bikerglen/poe-vfd-clock/boards/v1/control-board-page-1.png

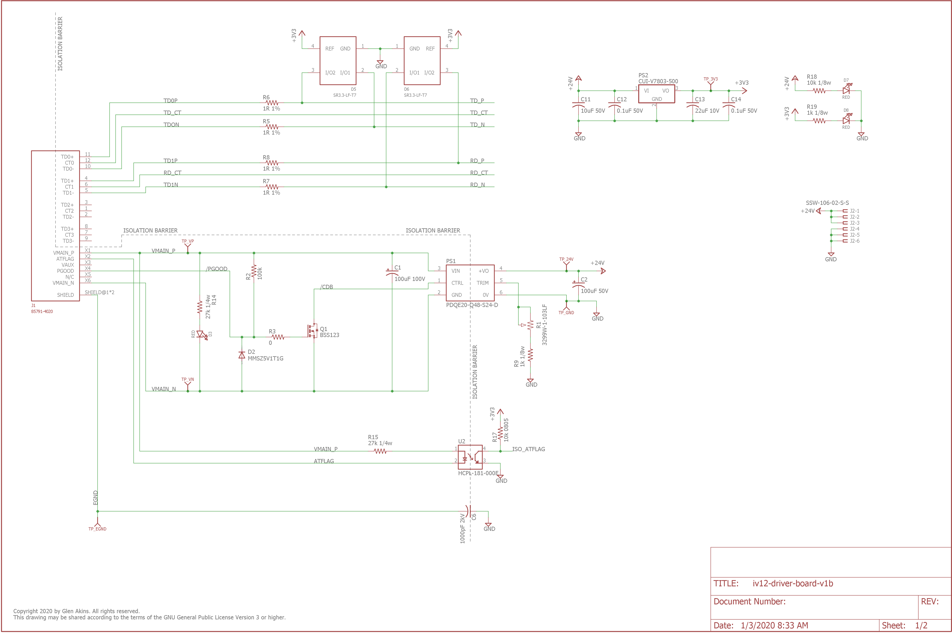
boards/v1/control-board-page-1.png
