bikerglen/poe-vfd-clock/boards/v1/control-board-page-2.png

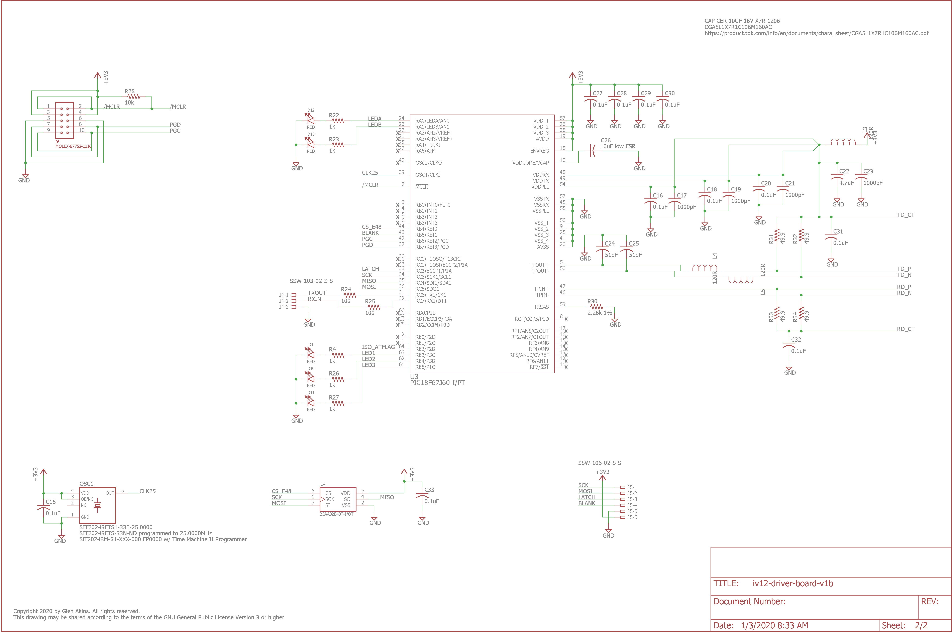
boards/v1/control-board-page-2.png
