bikerglen/poe-vfd-clock/boards/v1/tube-board-page-1.png

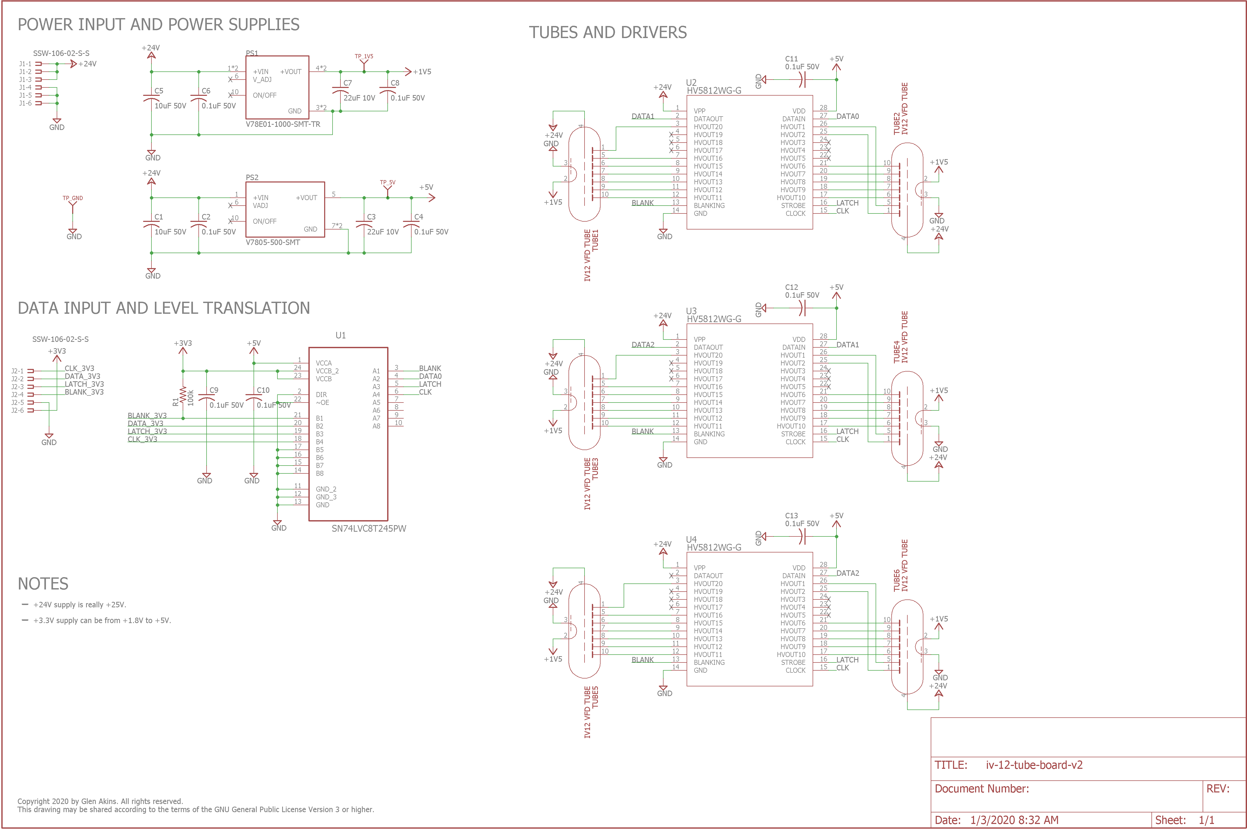
boards/v1/tube-board-page-1.png
