bikerglen/poe-vfd-clock/boards/v1/iv-12-project-bom.xlsx

Qty | Parts | Description | Size | Mfr | Mfr Part # | Dist | Dist Part 3 | Notes
2 | C1, C5 | CAP CER 10uF 50V 10% X7R SMD 1210 | 1210 | Kemet | C1210C106K5RACTU | Digi-Key | 399-11629-1-ND
4 | C2, C4, C6, C8 | CAP CER 0.1UF 50V X7R 1206 | 1206 | Kemet | C1206C104K5RAC7025 | Digi-Key | 399-7356-1-ND
2 | C3, C7 | CAP CER 22uF 10V 10% X7R SMD 1206 | 1206 | Kemet | C1206C226K8RAC7800 | Digi-Key | 399-11947-1-ND
5 | C9, C10, C11, C12, C13 | CAP CER 0.1u 50V 10% X7R SMD 0805 | 0805 | Kemet | C0805C104K5RACTU | Digi-Key | 399-1170-1-ND
2 | J1,J2 | CONN RCPT 6POS 0.1 GOLD PCB | --- | Samtec | ‎SSW-106-01-G-S‎ | Digi-Key | SAM1209-06-ND
1 | PS1 | DC-DC NON-ISOLATED, 1 A, 4.75 32 | --- | Cui | V78E01-1000-SMT-TR | Digi-Key | 102-5030-1-ND
1 | PS2 | DC DC CONVERTER 5V 2.5W | --- | Cui | V7805-500-SMT-TR | Digi-Key | 102-1958-1-ND
1 | R1 | RES SMD 100K OHM 5% 1/8W 0805 | 0805 | Panasonic | ERJ-6GEYJ104V | Digi-Key | P100KACT-ND
3 | TP1, TP2, TP3 | PC TEST POINT MINIATURE | --- | Keystone | 5000 | Digi-Key | 36-5000-ND
6 | TUBE1 - TUBE6 | IN12 VFD TUBE | --- | --- | --- | --- | ---
1 | U1 | IC TRNSLTR BIDIRECTIONAL 24TSSOP | --- | Texas Instruments | ‎SN74LVC8T245PWR‎ | Digi-Key | 296-18593-1-ND‎
3 | U2,U3,U4 | IC DISPLAY DVR 20CH 80V 28SOIC | --- | Microchip | ‎HV5812WG-G‎ | Digi-Key | HV5812WG-GCT-ND‎
60 | --- | CONN PIN RCPT .035-.041 KNURL | --- | Harwin | H3161-01 | Digi-Key | 952-1467-ND
4 | --- | M3 x 0.5 x 11MM F-F THREADED STANDOFF | --- | Würth Elektronik | ‎970110324‎ | Digi-Key | 732-12849-ND‎
8 | --- | M3 x 0.5 x 6MM PAN HEAD HEX SCREW | --- | McMaster Carr | 92095A179 | McMaster Carr | 92095A179
1 | C1 | CAP ALUM 100UF 20% 100V RADIAL | 12.5x5x14 | Nichicon | URY2A101MHD1TO | Digi-Key | 493-12135-1-ND
1 | C2 | CAP ALUM 100UF 20% 50V RADIAL | 10x5x10.5 | Nichicon | URZ1H101MPD1TD | Digi-Key | 493-11877-1-ND
1 | C6 | CAP CER 1000pF 2KV 10% X7R SMD 1206 | 1206 | Johanson Dielectrics | 202R18W102KV4E | Digi-Key | 709-1036-1-ND
1 | C11 | CAP CER 10uF 50V 10% X7R SMD 1210 | 1210 | Kemet | C1210C106K5RACTU | Digi-Key | 399-11629-1-ND
2 | C12, C14 | CAP CER 0.1u 50V 10% X7R SMD 0805 | 0805 | Kemet | C0805C104K5RACTU | Digi-Key | 399-1170-1-ND
1 | C13 | CAP CER 22uF 10V 10% X7R SMD 1206 | 1206 | Kemet | C1206C226K8RAC7800 | Digi-Key | 399-11947-1-ND
6 | C15, C27, C28, C29, C30, C33 | CAP CER 0.1uF 50V 20% X7R SMD 0603 | 0603 | TDK | C1608X7R1H104M | Digi-Key | 445-5098-1-ND
5 | C16, C18, C20, C31, C32 | CAP CER 0.1u 50V 10% X7R SMD 0805 | 0805 | Kemet | C0805C104K5RACTU | Digi-Key | 399-1170-1-ND
4 | C17, C19, C21, C23 | CAP CER 1000pF 50V 20% X7R SMD 0805 | 0805 | Kemet | C0805C102M5RACTU | Digi-Key | 399-1146-1-ND
1 | C22 | CAP CER 4.7uF 10V 10% X5R SMD 0805 | 0805 | Kemet | C0805C475K8PACTU | Digi-Key | 399-3133-1-ND
2 | C24, C25 | CAP CER 51pF 50V 5% NP0 SMD 0805 | 0805 | Yageo | CC0805JRNPO9BN510 | Digi-Key | 311-4239-1-ND
1 | C26 | CAP CER 10uF 16V 20% X7R SMD 1206 | 1206 | TDK | CGA5L1X7R1C106M160AC | Digi-Key | 445-12903-1-ND
8 | D1, D3, D7, D8, D10, D11, D12, D13 | LED RED CLEAR CHIP SMD 0805 | 0805 | Kingbright | APHCM2012SURCK-F01 | Digi-Key | 754-1097-1-ND
1 | D2 | Zener Diodes ZNR SOD123 500MW | SOD123 | On Semi | SZMMSZ5V1T1G | Mouser | 863-SZMMSZ5V1T1G
2 | D5, D6 | TVS DIODE 3.3V 7V SOT143 | --- | Bourns | CD143A-SR3.3 | Digi-Key | CD143A-SR3.3CT-ND
1 | J1 | MAGJACK GIG PDJACK 1X1 CLASS 4 | --- | Molex | 0857914020 | Digi-Key | WM9656-ND
2 | J2, J5 | CONN HEADER VERT 6POS 2.54MM | --- | Samtec | TSW-106-07-G-S | Digi-Key | SAM1029-06-ND
1 | J4 | CONN HEADER VERT 3POS 2.54MM | --- | Samtec | TSW-103-07-G-S | Digi-Key | SAM1029-03-ND
1 | J6 | CONN HEADER VERT 10POS 2MM | --- | Molex | 0877581016 | Digi-Key | WM18836-ND
3 | L3, L4, L5 | FERRITE BEAD 120 OHM 0603 1LN | M1608 | TDK | MMZ1608B121CTAH0 | Digi-Key | 445-2164-1-ND
1 | OSC1 | MEMS OSC PROG XO LVCMOS 3.3V | --- | Si Time | SIT2024BETS-33N | Digi-Key | SIT2024BETS-33N-ND | 25.0000 MHz
1 | PS1 | DC-DC ISOLATED, 20 W, 18-75 VDC | --- | Cui | PDQE20-Q48-S24-D | Digi-Key | 102-6275-ND
1 | PS2 | DC DC CONVERTER 3.3V 1.65W | --- | Cui | V7803-500 | Digi-Key | 102-1708-ND
1 | Q1 | MOSFET MOSFET SOT-23 N-CH | SOT23 | On Semi | BSS123 | Mouser | 512-BSS123
1 | R1 | RES SMD 51K OHM 5% 1/8W 0805 | 0805 | Panasonic | ERJ-6GEYJ513V | Digi-Key | P51KACT-ND
1 | R9 | TRIMMER 10K OHM 0.5W PC PIN TOP | --- | Bourns | 3299W-1-103LF | Digi-Key | 3299W-103LF-ND
2 | R14, R15 | RES SMD 27K OHM 5% 1/4W 1206 | 1206 | Panasonic | ERJ-8GEYJ273V | Digi-Key | P27KECT-ND
1 | R30 | RES SMD 2.26K OHM 1% 1/8W 0805 | 0805 | Panasonic | ERJ-6ENF2261V | Digi-Key | P2.26KCCT-ND
4 | R31, R32, R33, R34 | RES SMD 49.9 OHM 1% 1/8W 0805 | 0805 | Panasonic | ERJ-6ENF49R9V | Digi-Key | P49.9CCT-ND
1 | R2 | RES SMD 100K OHM 5% 1/8W 0805 | 0805 | Panasonic | ERJ-6GEYJ104V | Digi-Key | P100KACT-ND
1 | R3 | Thick Film Resistors - SMD 0805 Zero ohm Jumper AEC-Q200 | 0805 | Panasonic | ERJ-S060R00V | Mouser | 667-ERJ-S060R00V
6 | R4, R19, R22, R23, R26, R27 | RES SMD 1K OHM 5% 1/8W 0805 | 0805 | Panasonic | ERJ-6GEYJ102V | Digi-Key | P1.0KACT-ND
4 | R5, R6, R7, R8 | RES SMD 1 OHM 1% 1/8W 0805 | 0805 | Panasonic | ERJ-6RQF1R0V | Digi-Key | P1.0DCT-ND
3 | R17, R18, R28 | RES SMD 10K OHM 5% 1/8W 0805 | 0805 | Panasonic | ERJ-6GEYJ103V | Digi-Key | P10KACT-ND
2 | R24, R25 | RES SMD 100 OHM 5% 1/8W 0805 | 0805 | Panasonic | ERJ-6GEYJ101V | Digi-Key | P100ACT-ND
6 | TP1, TP2, TP3, TP4, TP5, TP6 | PC TEST POINT MINIATURE | --- | Keystone | 5000 | Digi-Key | 36-5000-ND
1 | U2 | OPTOISO 3.75KV TRANSISTOR 4SOIC | --- | Broadcom | HCPL-181-000E | Digi-Key | 516-1646-1-ND
1 | U3 | IC MCU 8BIT 128KB FLASH 64TQFP | --- | Microchip | PIC18F67J60-I/PT | Digi-Key | PIC18F67J60-I/PT-ND
1 | U4 | IC EEPROM 2K SPI 10MHZ SOT23-6 | --- | Microchip | 25AA02E48T-I/OT | Digi-Key | 25AA02E48T-I/OTCT-ND
 | ORDERED
 | ON-HAND
 | ORDER
