bikerglen/poe-vfd-clock/boards/v1/iv12-driver-board-v1b.brd

## EAGLE design boards/v1/iv12-driver-board-v1b.brd (2020-01-13)

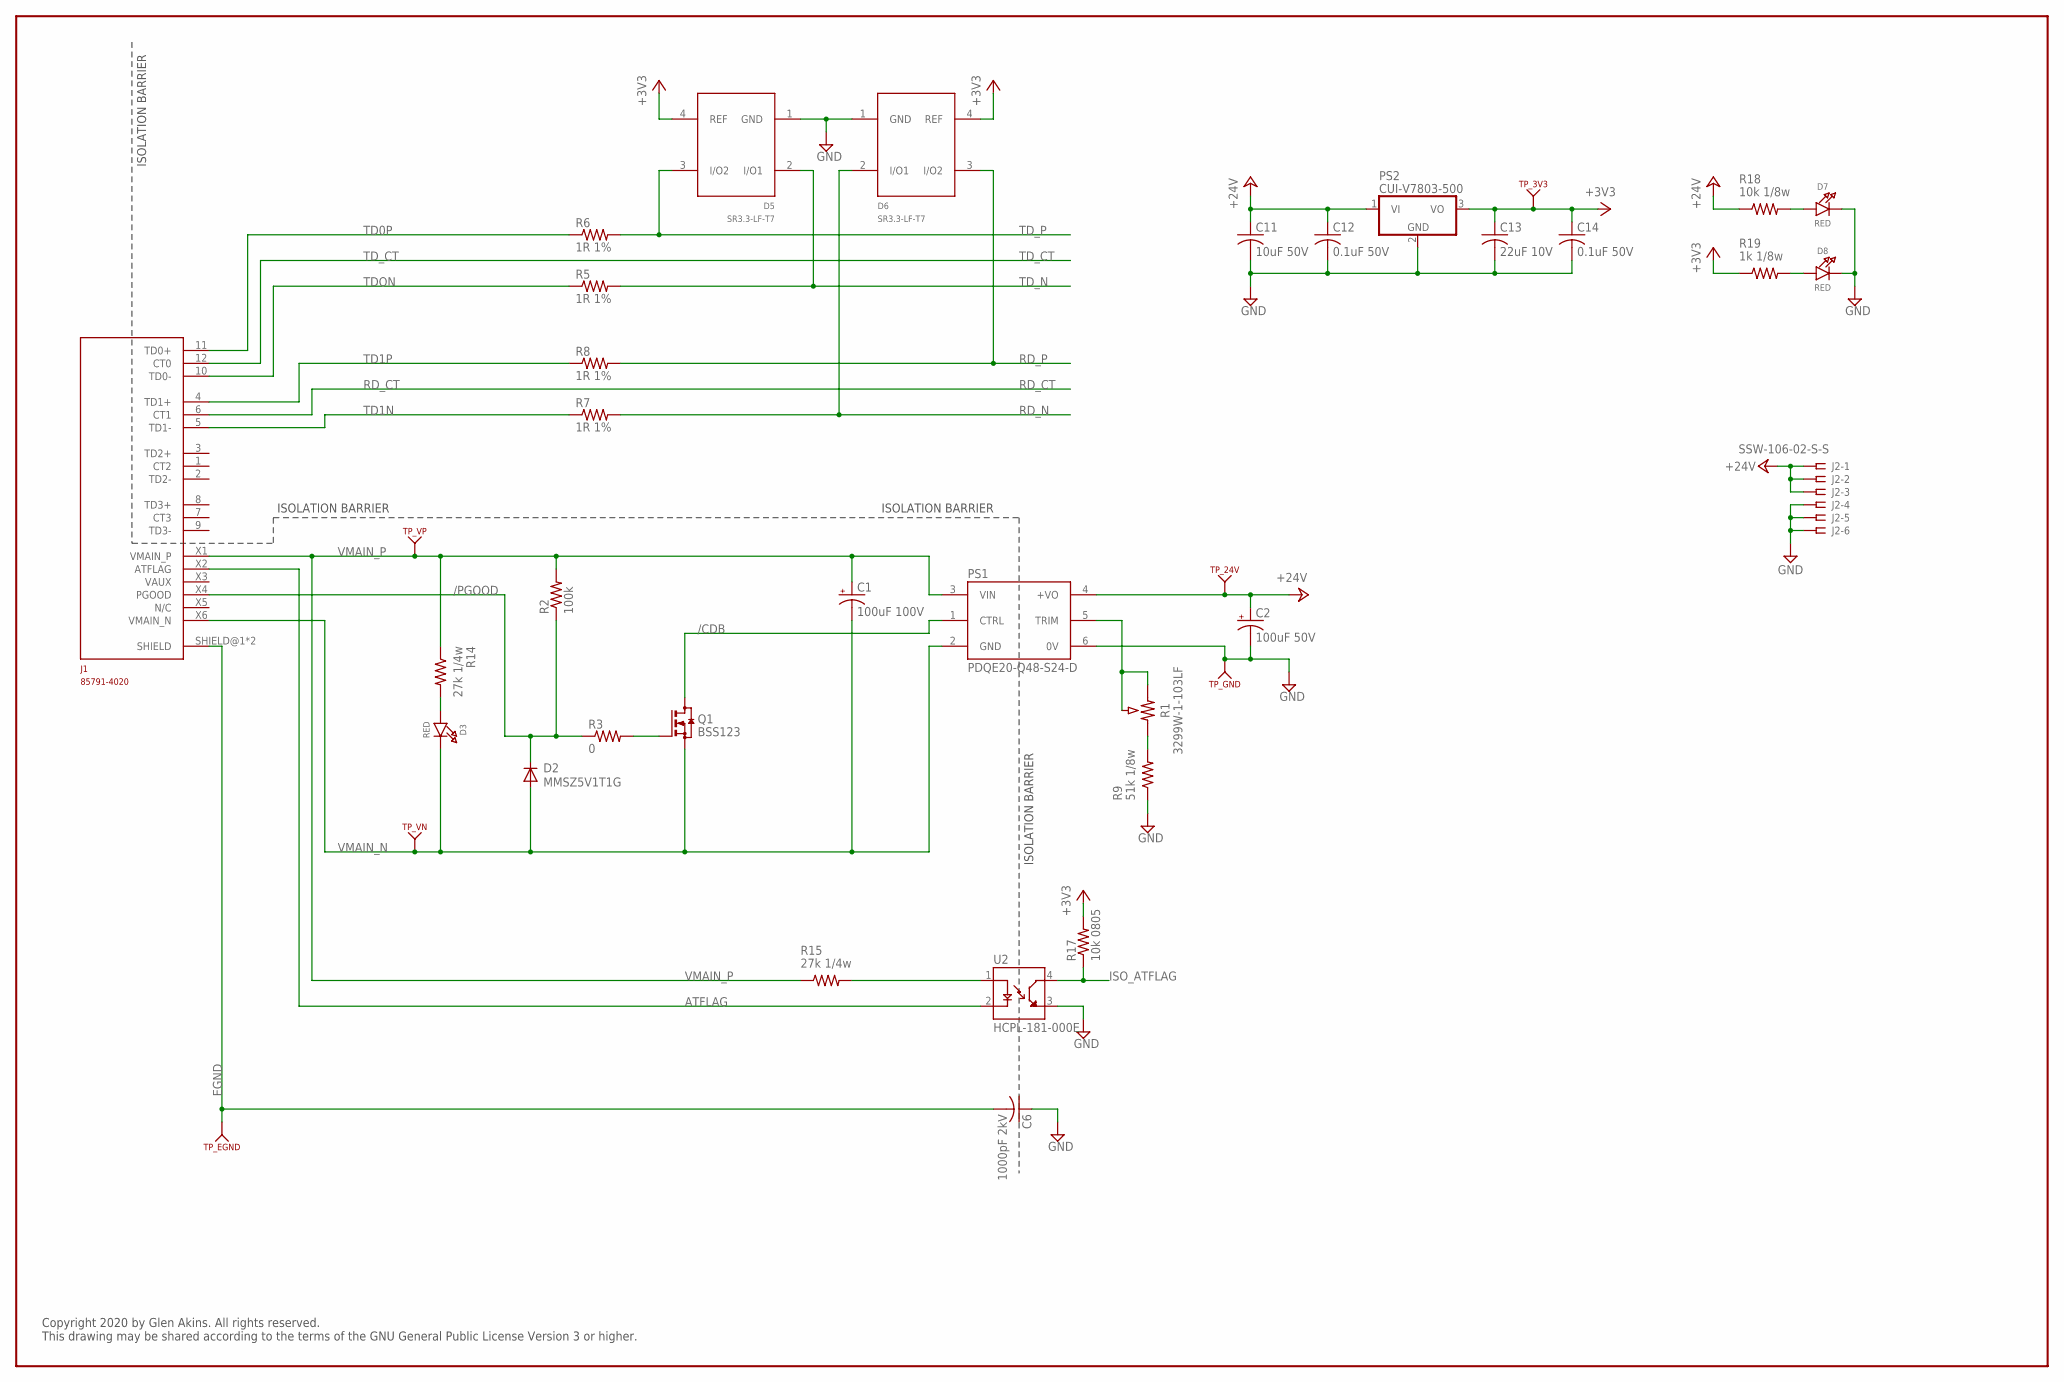
[picture p4: schematic iv12-driver-board-v1b.sch, sheet 1]

Parts:
C1: 100uF 100V; E5-13
C2: 100uF 50V; E5-10,5
C6: 1000pF 2kV; C1206K
C11: 10uF 50V; C1210K; MFR_PART_NO C1210C106K5RACTU
C12, C14: 0.1uF 50V; C0805; MFR_PART_NO C1206S104M5RACTU
C13: 22uF 10V; C1206K; MFR_PART_NO C1206C226K8RAC7800
D2: MMSZ5V1T1G; SOD123
D3, D7, D8: RED; CHIPLED_0805_NOOUTLINE
D5, D6: SR3.3-LF-T7; SOT143B
J1: 85791-4020; 85791-X020
J2: SSW-106-02-S-S
PS1: PDQE20-Q48-S24-D; CONV_PDQE20-Q48-S5-D
PS2: CUI-V7803-500; CUI-78XX-500
Q1: BSS123; SOT23
R1: 3299W-1-103LF; POT_3299W
R2: 100k; R0805
R3: 0; R0805
R5, R6, R7, R8: 1R 1%; R0805
R9: 51k 1/8w; R0805
R14, R15: 27k 1/4w; R1206
R17: 10k 0805; R0805
R18: 10k 1/8w; R0805
R19: 1k 1/8w; R0805
TP_3V3, TP_24V: KEYSTONE_500X; KEYSTONE_TP500X
TP_EGND: KEYSTONE_500X; KEYSTONE_TP500X
TP_GND: KEYSTONE_500X; KEYSTONE_TP500X
TP_VN: KEYSTONE_500X; KEYSTONE_TP500X
TP_VP: KEYSTONE_500X; KEYSTONE_TP500X
U2: HCPL-181-000E; SOIC254P675X240-4N

Connections:
+3V3: C13.1, C14.1, D5.4 (REF), D6.4 (REF), PS2.3 (VO), R17.2, R19.1, TP_3V3.1; also elsewhere on the board
+24V: C2.+, C11.1, C12.1, J2.1, J2.2, J2.3, PS1.4 (+VO), PS2.1 (VI), R18.1, TP_24V.1
/CDB: PS1.1 (CTRL), Q1.3 (D)
/PGOOD: D2.C, J1.X4 (PGOOD), R2.1, R3.1
ATFLAG: J1.X2 (ATFLAG), U2.2 (CATHODE)
EGND: C6.2, J1.SHIELD@1 (SHIELD), J1.SHIELD@2 (SHIELD), TP_EGND.1
GND: C2.-, C6.1, C11.2, C12.2, C13.2, C14.2, D5.1 (GND), D6.1 (GND), D7.C, D8.C, J2.4, J2.5, J2.6, PS1.6 (0V), PS2.2 (GND), R9.1, TP_GND.1, U2.3 (EMITTER); also elsewhere on the board
ISO_ATFLAG: R17.1, U2.4 (COLLECTOR); also elsewhere on the board
unnamed: R1.1, R9.2
unnamed: R15.2, U2.1 (ANODE)
unnamed: Q1.1 (G), R3.2
unnamed: D3.A, R14.2
unnamed: D7.A, R18.2
unnamed: D8.A, R19.2
RD_CT: J1.6 (CT1); also elsewhere on the board
RD_N: D6.2 (I/O1), R7.2; also elsewhere on the board
RD_P: D6.3 (I/O2), R8.2; also elsewhere on the board
TD0P: J1.11 (TD0+), R6.1
TD1N: J1.5 (TD1-), R7.1
TD1P: J1.4 (TD1+), R8.1
TDON: J1.10 (TD0-), R5.1
TD_CT: J1.12 (CT0); also elsewhere on the board
TD_N: D5.2 (I/O1), R5.2; also elsewhere on the board
TD_P: D5.3 (I/O2), R6.2; also elsewhere on the board
V24ADJ: PS1.5 (TRIM), R1.2, R1.3
VMAIN_N: C1.-, D2.A, D3.C, J1.X6 (VMAIN_N), PS1.2 (GND), Q1.2 (S), TP_VN.1
VMAIN_P: C1.+, J1.X1 (VMAIN_P), PS1.3 (VIN), R2.2, R14.1, R15.1, TP_VP.1

Notes on the sheet:
ISOLATION BARRIER
Copyright 2020 by Glen Akins. All rights reserved. This drawing may be shared according to the terms of the GNU General Public License Version 3 or higher.

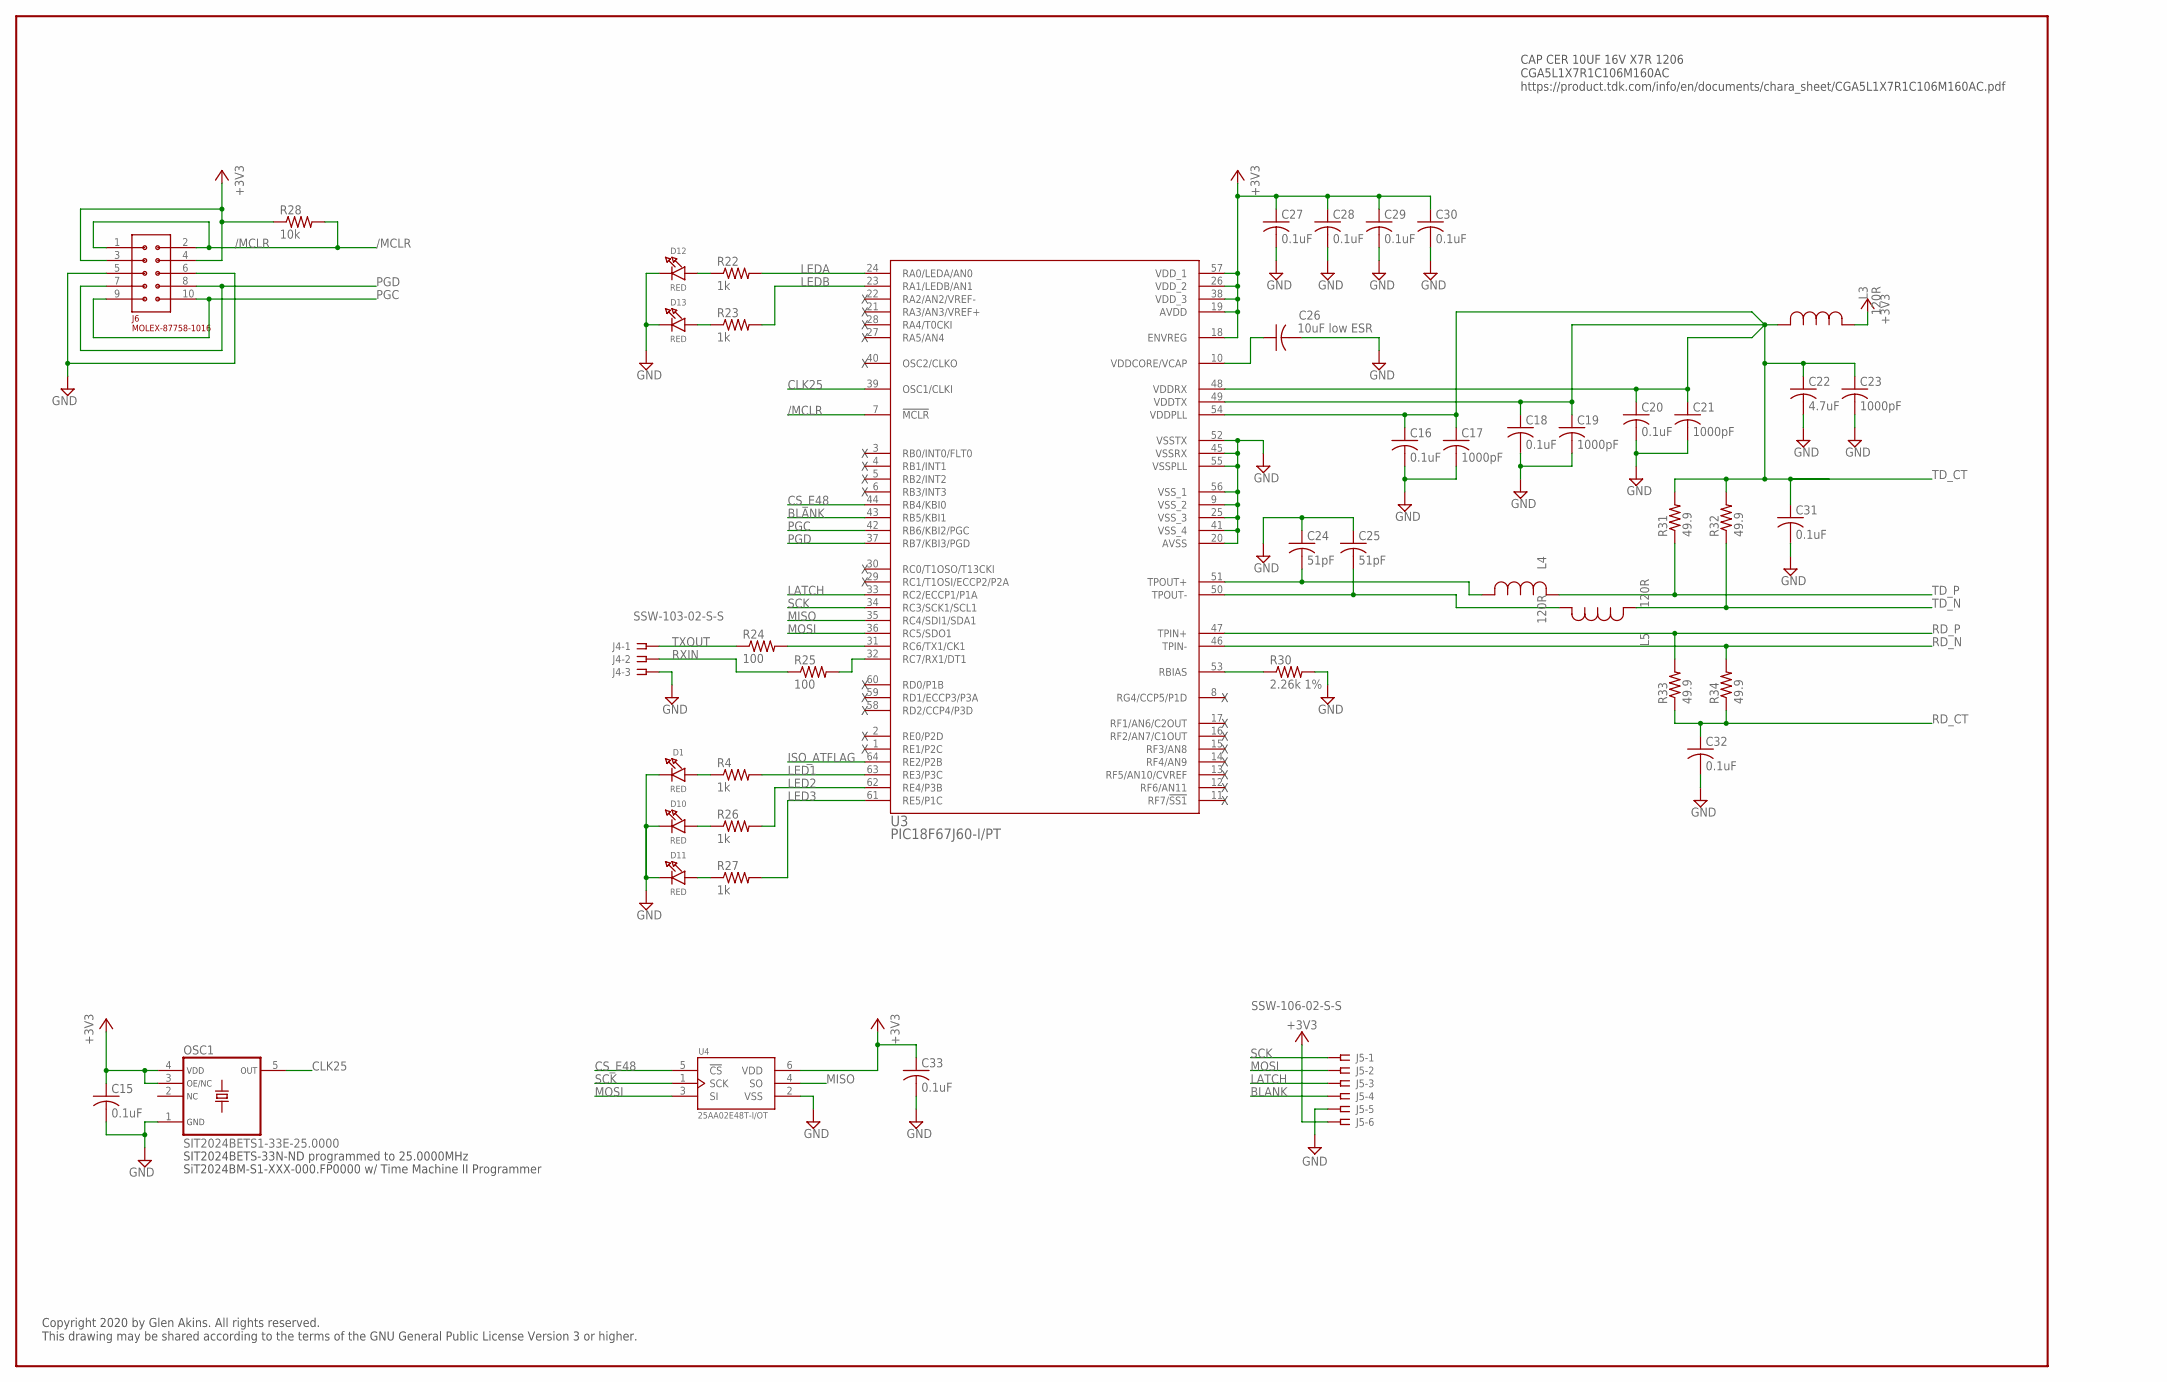
[picture p5: schematic iv12-driver-board-v1b.sch, sheet 2]

Parts:
C15, C27, C28, C29, C30, C33: 0.1uF; C0603
C16, C18, C20, C31, C32: 0.1uF; C0805
C17, C19, C21, C23: 1000pF; C0805
C22: 4.7uF; C0805
C24, C25: 51pF; C0805
C26: 10uF low ESR; C1206
D1, D10, D11, D12, D13: RED; CHIPLED_0805_NOOUTLINE
J4: SSW-103-02-S-S
J5: SSW-106-02-S-S
J6: MOLEX-87758-1016; CON-2MM-2X5; MFR_PART_NO 87758-1016
L3, L4, L5: 120R; IND_1608-M
OSC1: SIT2024BETS1-33E-25.0000; SOT23-5
R4, R22, R23, R26, R27: 1k; R0805
R24, R25: 100; R0805
R28: 10k; R0805
R30: 2.26k 1%; R0805
R31, R32, R33, R34: 49.9; R0805
U3: PIC18F67J60-I/PT; TQFP64_10X10MC
U4: 25AA02E48T-I/OT; SOT95P270X145-6N

Connections:
+3V3: C15.1, C27.1, C28.1, C29.1, C30.1, C33.1, J5.6, J6.3, J6.4, L3.2, OSC1.3 (OE/NC), OSC1.4 (VDD), R28.1, U3.18 (ENVREG), U3.19 (AVDD), U3.26 (VDD_2), U3.38 (VDD_3), U3.57 (VDD_1), U4.6 (VDD); also elsewhere on the board
/MCLR: J6.1, J6.2, R28.2, U3.7 (!MCLR)
BLANK: J5.4, U3.43 (RB5/KBI1)
CLK25: OSC1.5 (OUT), U3.39 (OSC1/CLKI)
CS_E48: U3.44 (RB4/KBI0), U4.5 (!CS)
GND: C15.2, C16.2, C17.2, C18.2, C19.2, C20.2, C21.2, C22.2, C23.2, C24.1, C25.1, C26.2, C27.2, C28.2, C29.2, C30.2, C31.2, C32.2, C33.2, D1.C, D10.C, D11.C, D12.C, D13.C, J4.3, J5.5, J6.5, J6.6, OSC1.1 (GND), R30.2, U3.9 (VSS_2), U3.20 (AVSS), U3.25 (VSS_3), U3.41 (VSS_4), U3.45 (VSSRX), U3.52 (VSSTX), U3.55 (VSSPLL), U3.56 (VSS_1), U4.2 (VSS); also elsewhere on the board
ISO_ATFLAG: U3.64 (RE2/P2B); also elsewhere on the board
LATCH: J5.3, U3.33 (RC2/ECCP1/P1A)
LED1: R4.2, U3.63 (RE3/P3C)
LED2: R26.2, U3.62 (RE4/P3B)
LED3: R27.2, U3.61 (RE5/P1C)
LEDA: R22.2, U3.24 (RA0/LEDA/AN0)
LEDB: R23.2, U3.23 (RA1/LEDB/AN1)
MISO: U3.35 (RC4/SDI1/SDA1), U4.4 (SO)
MOSI: J5.2, U3.36 (RC5/SDO1), U4.3 (SI)
unnamed: D1.A, R4.1
unnamed: R30.1, U3.53 (RBIAS)
unnamed: D13.A, R23.1
unnamed: D10.A, R26.1
unnamed: D11.A, R27.1
unnamed: D12.A, R22.1
PGC: J6.9, J6.10, U3.42 (RB6/KBI2/PGC)
PGD: J6.7, J6.8, U3.37 (RB7/KBI3/PGD)
RD_CT: C32.1, R33.1, R34.1; also elsewhere on the board
RD_N: R34.2, U3.46 (TPIN-); also elsewhere on the board
RD_P: R33.2, U3.47 (TPIN+); also elsewhere on the board
RXD: R25.2, U3.32 (RC7/RX1/DT1)
RXIN: J4.2, R25.1
SCK: J5.1, U3.34 (RC3/SCK1/SCL1), U4.1 (SCK)
TDF_N: C25.2, L5.1, U3.50 (TPOUT-)
TDF_P: C24.2, L4.1, U3.51 (TPOUT+)
TD_CT: C16.1, C17.1, C18.1, C19.1, C20.1, C21.1, C22.1, C23.1, C31.1, L3.1, R31.2, R32.2, U3.48 (VDDRX), U3.49 (VDDTX), U3.54 (VDDPLL); also elsewhere on the board
TD_N: L5.2, R32.1; also elsewhere on the board
TD_P: L4.2, R31.1; also elsewhere on the board
TXD: R24.2, U3.31 (RC6/TX1/CK1)
TXOUT: J4.1, R24.1
VCAP: C26.1, U3.10 (VDDCORE/VCAP)

Notes on the sheet:
SIT2024BETS-33N-ND programmed to 25.0000MHz
SiT2024BM-S1-XXX-000.FP0000 w/ Time Machine II Programmer
CAP CER 10UF 16V X7R 1206 CGA5L1X7R1C106M160AC https://product.tdk.com/info/en/documents/chara_sheet/CGA5L1X7R1C106M160AC.pdf
Copyright 2020 by Glen Akins. All rights reserved. This drawing may be shared according to the terms of the GNU General Public License Version 3 or higher.

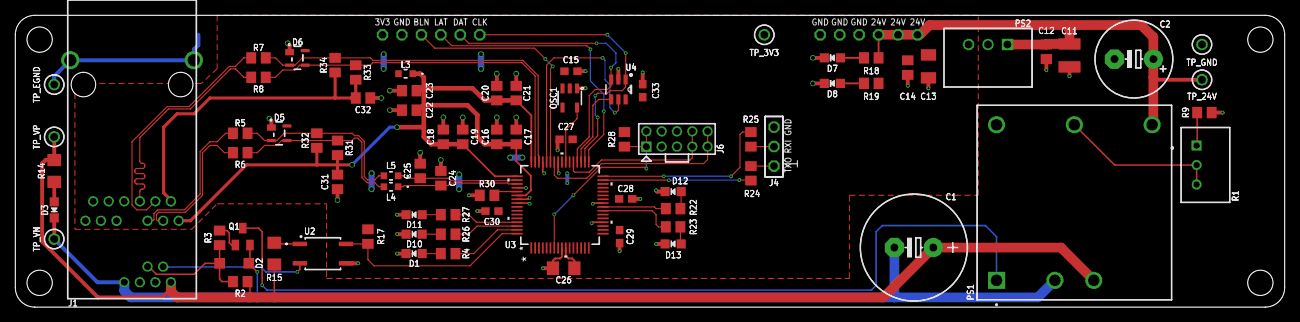
[picture p6: board iv12-driver-board-v1b.brd from above]

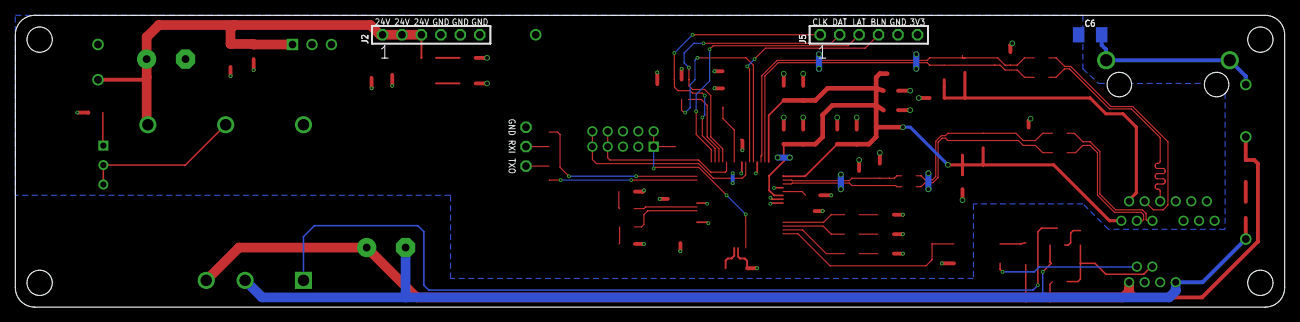
[picture p7: board iv12-driver-board-v1b.brd from below]

Board: 2 copper layers, 165.7 x 38.1 mm, 84 parts (3 on the bottom side), 55 nets.
