bikerglen/poe-vfd-clock/boards/v1/iv-12-tube-board-v2.brd

## EAGLE design boards/v1/iv-12-tube-board-v2.brd (2020-01-12)

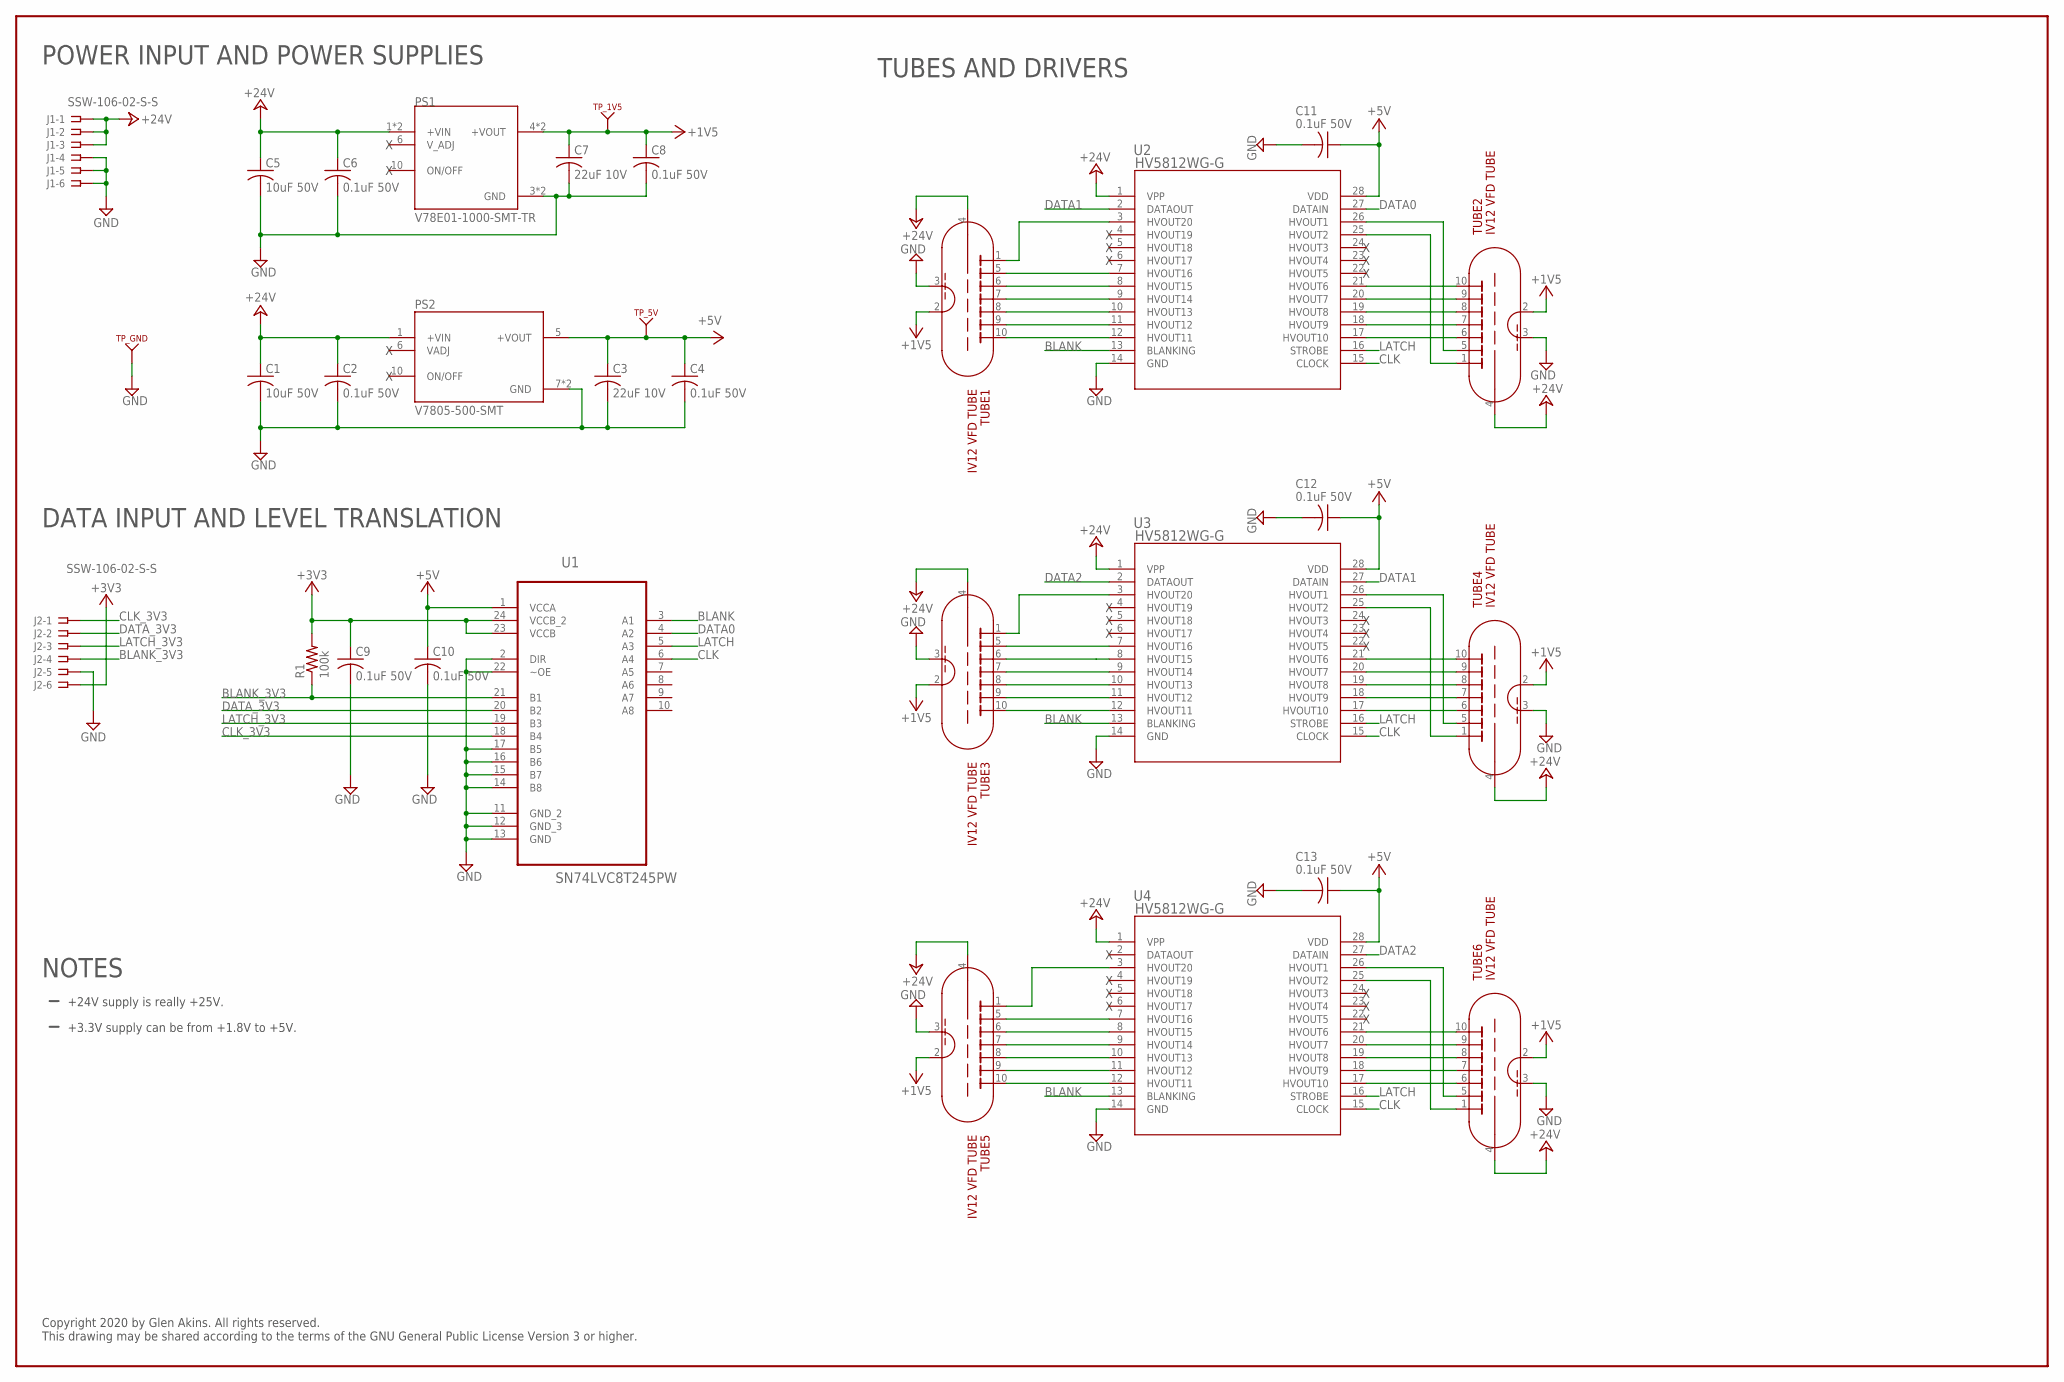
[picture p8: schematic iv-12-tube-board-v2.sch, sheet 1]

Parts:
C1, C5: 10uF 50V; C1210K; MFR_PART_NO C1210C106K5RACTU
C2, C4, C6, C8: 0.1uF 50V; C1206K; MFR_PART_NO C1206S104M5RACTU
C3, C7: 22uF 10V; C1206K; MFR_PART_NO C1206C226K8RAC7800
C9, C10: 0.1uF 50V; C0805K
C11, C12, C13: 0.1uF 50V; C0805
J1, J2: SSW-106-02-S-S
PS1: V78E01-1000-SMT-TR; CONV_V78E01-1000-SMT-TR
PS2: V7805-500-SMT; CONV_V7805-500-SMT
R1: 100k; R0805
TP_1V5, TP_5V: KEYSTONE_500X; KEYSTONE_TP500X
TP_GND: KEYSTONE_500X; KEYSTONE_TP500X
TUBE1, TUBE2, TUBE3, TUBE4, TUBE5, TUBE6: IV12 VFD TUBE; IV-12-VFD-TUBE-11.9MM-10PIN-34DEG
U1: SN74LVC8T245PW; SOP65P640X120-24N
U2, U3, U4: HV5812WG-G; SOW28_17P90X7P50

Connections:
+1V5: C7.1, C8.1, PS1.4 (+VOUT), PS1.5 (+VOUT), TP_1V5.1, TUBE1.2, TUBE2.2, TUBE3.2, TUBE4.2, TUBE5.2, TUBE6.2
+3V3: C9.1, J2.6, R1.2, U1.23 (VCCB), U1.24 (VCCB_2)
+5V: C3.1, C4.1, C10.1, C11.1, C12.1, C13.1, PS2.5 (+VOUT), TP_5V.1, U1.1 (VCCA), U2.28 (VDD), U3.28 (VDD), U4.28 (VDD)
+24V: C1.1, C2.1, C5.1, C6.1, J1.1, J1.2, J1.3, PS1.1 (+VIN), PS1.2 (+VIN), PS2.1 (+VIN), TUBE1.4, TUBE2.4, TUBE3.4, TUBE4.4, TUBE5.4, TUBE6.4, U2.1 (VPP), U3.1 (VPP), U4.1 (VPP)
BLANK: U1.3 (A1), U2.13 (BLANKING), U3.13 (BLANKING), U4.13 (BLANKING)
BLANK_3V3: J2.4, R1.1, U1.21 (B1)
CLK: U1.6 (A4), U2.15 (CLOCK), U3.15 (CLOCK), U4.15 (CLOCK)
CLK_3V3: J2.1, U1.18 (B4)
DATA0: U1.4 (A2), U2.27 (DATAIN)
DATA1: U2.2 (DATAOUT), U3.27 (DATAIN)
DATA2: U3.2 (DATAOUT), U4.27 (DATAIN)
DATA_3V3: J2.2, U1.20 (B2)
GND: C1.2, C2.2, C3.2, C4.2, C5.2, C6.2, C7.2, C8.2, C9.2, C10.2, C11.2, C12.2, C13.2, J1.4, J1.5, J1.6, J2.5, PS1.3 (GND), PS1.7 (GND), PS2.7 (GND), PS2.9 (GND), TP_GND.1, TUBE1.3, TUBE2.3, TUBE3.3, TUBE4.3, TUBE5.3, TUBE6.3, U1.2 (DIR), U1.11 (GND_2), U1.12 (GND_3), U1.13 (GND), U1.14 (B8), U1.15 (B7), U1.16 (B6), U1.17 (B5), U1.22 (~OE), U2.14 (GND), U3.14 (GND), U4.14 (GND)
LATCH: U1.5 (A3), U2.16 (STROBE), U3.16 (STROBE), U4.16 (STROBE)
LATCH_3V3: J2.3, U1.19 (B3)
unnamed: TUBE1.1, U2.3 (HVOUT20)
unnamed: TUBE1.10, U2.12 (HVOUT11)
unnamed: TUBE1.9, U2.11 (HVOUT12)
unnamed: TUBE1.8, U2.10 (HVOUT13)
unnamed: TUBE1.7, U2.9 (HVOUT14)
unnamed: TUBE1.6, U2.8 (HVOUT15)
unnamed: TUBE1.5, U2.7 (HVOUT16)
unnamed: TUBE2.1, U2.25 (HVOUT2)
unnamed: TUBE2.5, U2.26 (HVOUT1)
unnamed: TUBE2.6, U2.17 (HVOUT10)
unnamed: TUBE2.7, U2.18 (HVOUT9)
unnamed: TUBE2.8, U2.19 (HVOUT8)
unnamed: TUBE2.9, U2.20 (HVOUT7)
unnamed: TUBE2.10, U2.21 (HVOUT6)
unnamed: TUBE3.1, U3.3 (HVOUT20)
unnamed: TUBE5.1, U4.3 (HVOUT20)
unnamed: TUBE3.5, U3.7 (HVOUT16)
unnamed: TUBE3.6, U3.8 (HVOUT15)
unnamed: TUBE3.7, U3.9 (HVOUT14)
unnamed: TUBE3.8, U3.10 (HVOUT13)
unnamed: TUBE3.9, U3.11 (HVOUT12)
unnamed: TUBE3.10, U3.12 (HVOUT11)
unnamed: TUBE5.10, U4.12 (HVOUT11)
unnamed: TUBE5.9, U4.11 (HVOUT12)
unnamed: TUBE5.8, U4.10 (HVOUT13)
unnamed: TUBE5.7, U4.9 (HVOUT14)
unnamed: TUBE5.6, U4.8 (HVOUT15)
unnamed: TUBE5.5, U4.7 (HVOUT16)
unnamed: TUBE4.5, U3.26 (HVOUT1)
unnamed: TUBE4.1, U3.25 (HVOUT2)
unnamed: TUBE4.10, U3.21 (HVOUT6)
unnamed: TUBE4.9, U3.20 (HVOUT7)
unnamed: TUBE4.8, U3.19 (HVOUT8)
unnamed: TUBE4.7, U3.18 (HVOUT9)
unnamed: TUBE4.6, U3.17 (HVOUT10)
unnamed: TUBE6.6, U4.17 (HVOUT10)
unnamed: TUBE6.7, U4.18 (HVOUT9)
unnamed: TUBE6.8, U4.19 (HVOUT8)
unnamed: TUBE6.9, U4.20 (HVOUT7)
unnamed: TUBE6.10, U4.21 (HVOUT6)
unnamed: TUBE6.5, U4.26 (HVOUT1)
unnamed: TUBE6.1, U4.25 (HVOUT2)

Notes on the sheet:
POWER INPUT AND POWER SUPPLIES
DATA INPUT AND LEVEL TRANSLATION
TUBES AND DRIVERS
NOTES
+24V supply is really +25V.
+3.3V supply can be from +1.8V to +5V.
Copyright 2020 by Glen Akins. All rights reserved. This drawing may be shared according to the terms of the GNU General Public License Version 3 or higher.

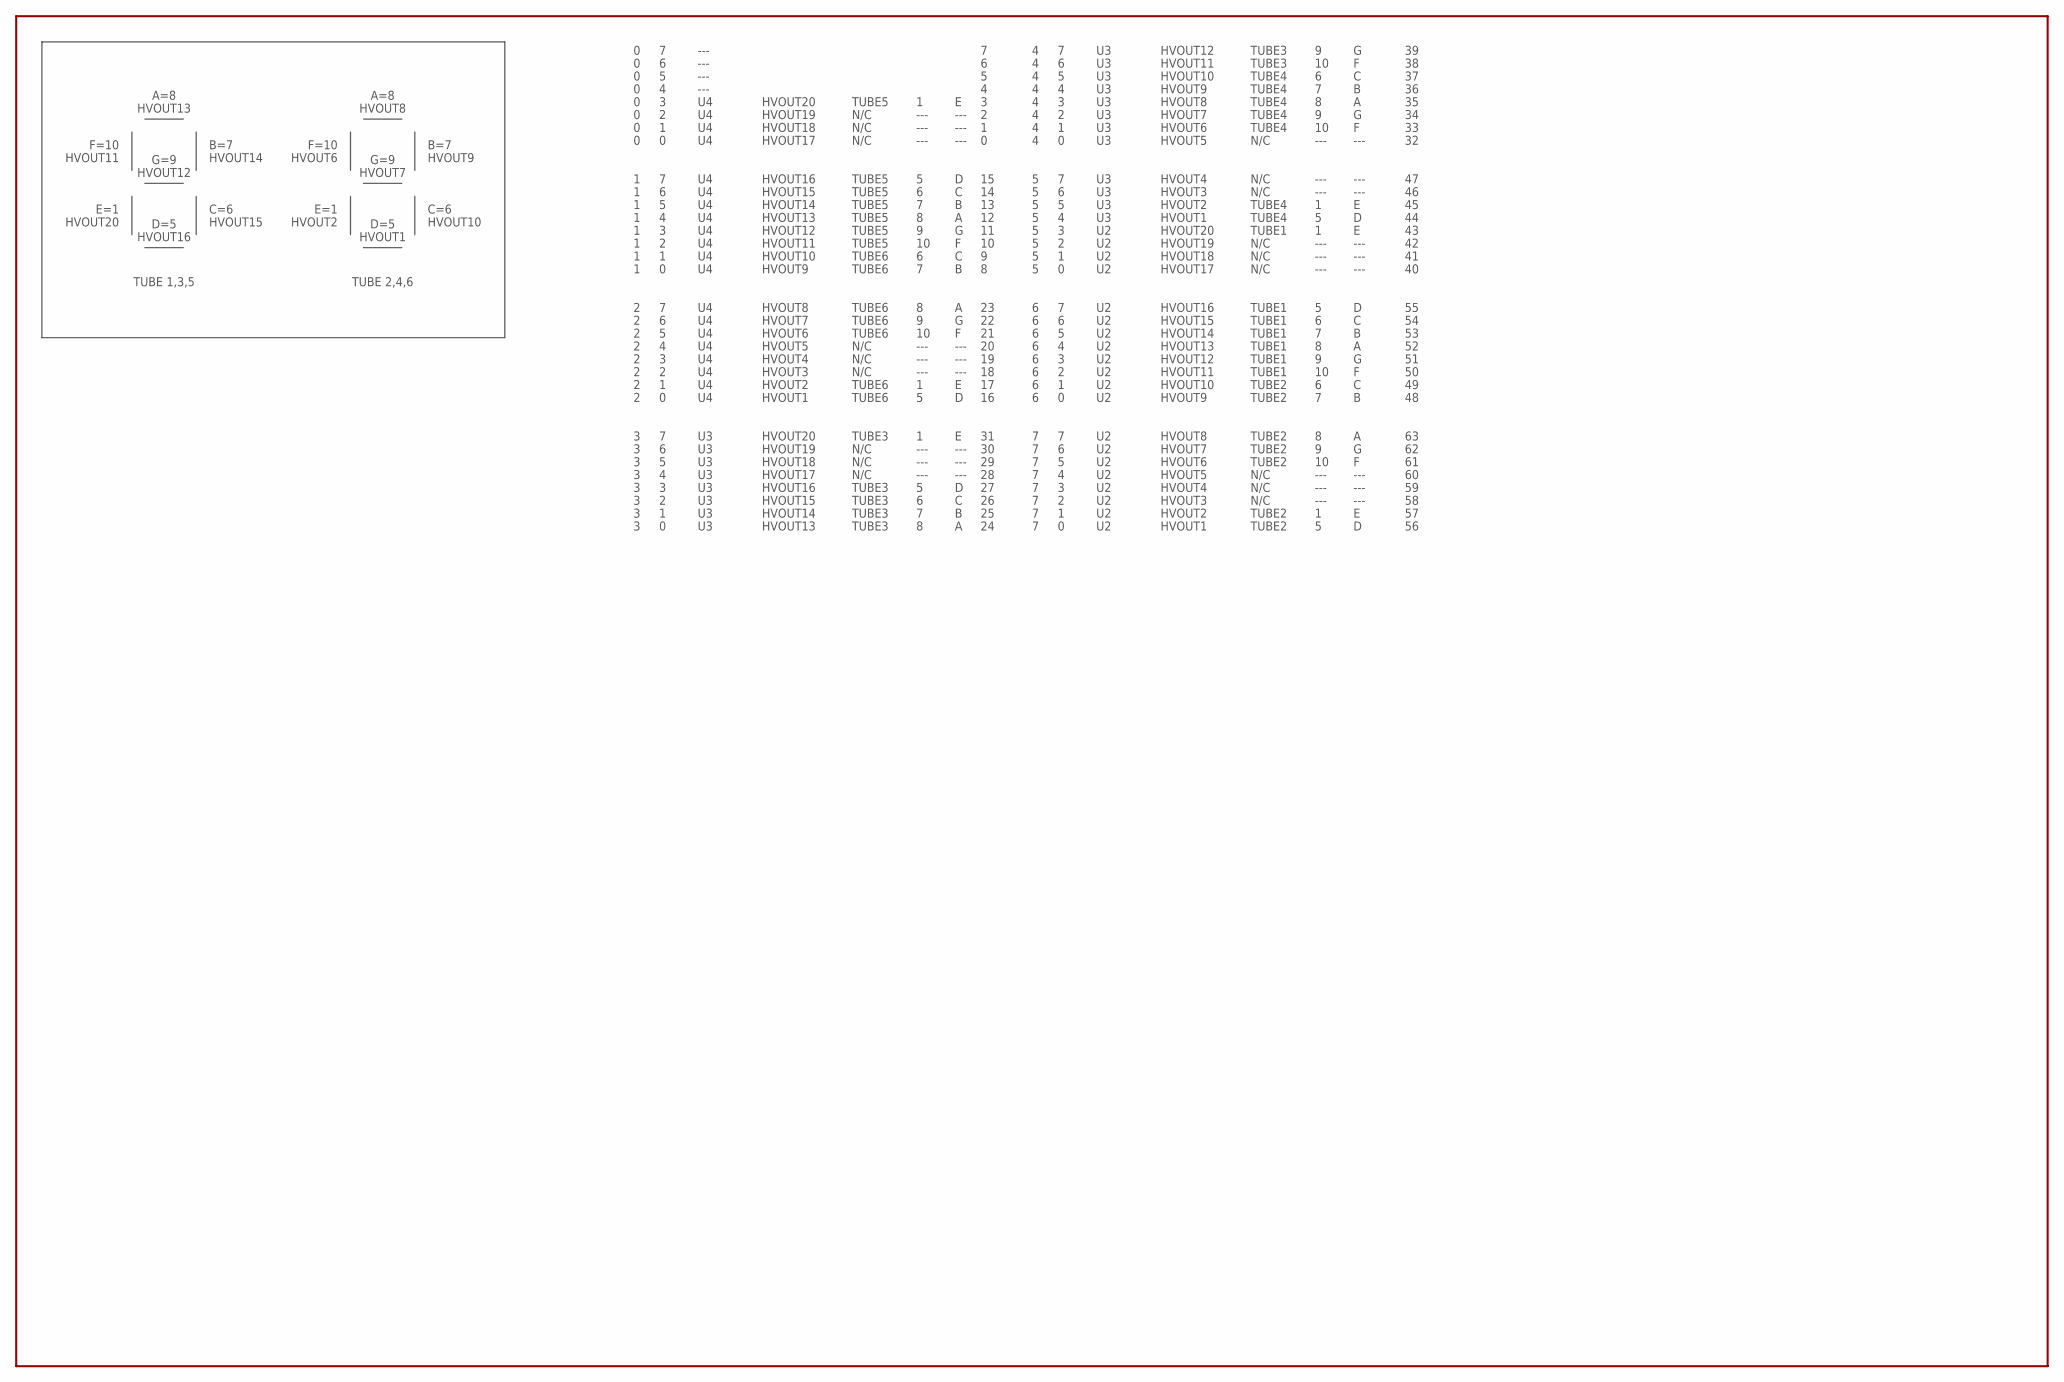
[picture p9: schematic iv-12-tube-board-v2.sch, sheet 2]

Notes on the sheet:
A=8
B=7
C=6
D=5
E=1
F=10
G=9
HVOUT1
HVOUT2
HVOUT6
HVOUT7
HVOUT8
HVOUT9
HVOUT10
HVOUT16
HVOUT20
HVOUT11
HVOUT12
HVOUT13
HVOUT14
HVOUT15
TUBE 2,4,6
TUBE 1,3,5
HVOUT4
HVOUT3
HVOUT5
HVOUT17
HVOUT18
HVOUT19
TUBE2
TUBE1
N/C
---
TUBE4
TUBE3
TUBE6
TUBE5

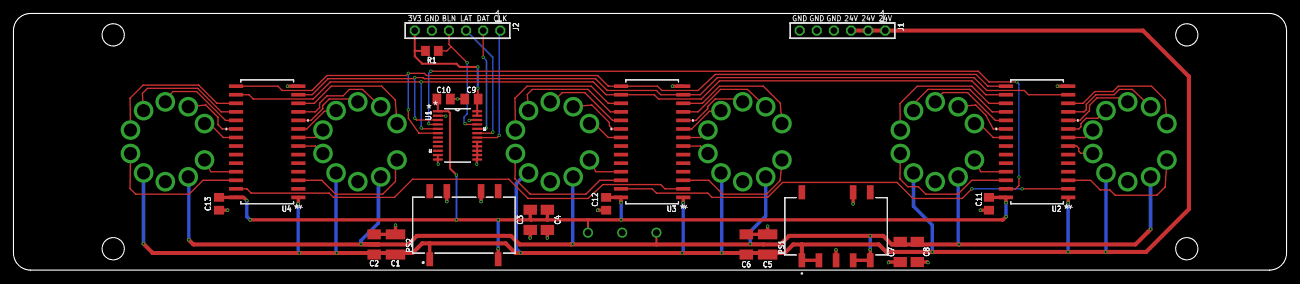
[picture p10: board iv-12-tube-board-v2.brd from above]

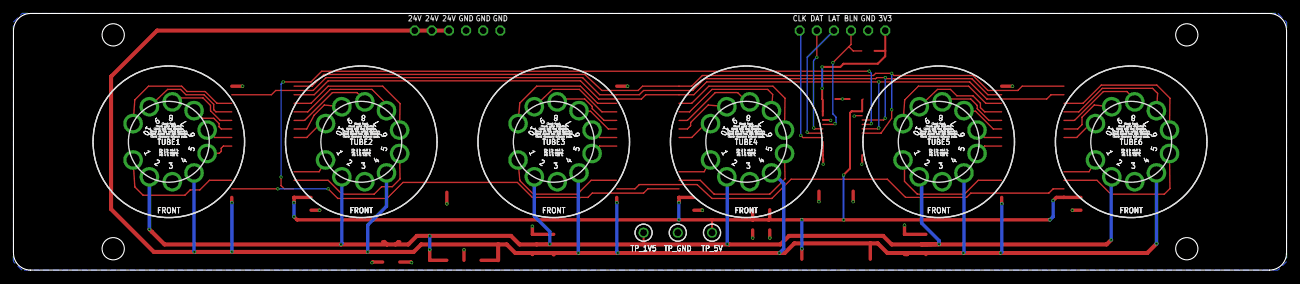
[picture p11: board iv-12-tube-board-v2.brd from below]

Board: 2 copper layers, 189.0 x 38.1 mm, 31 parts (9 on the bottom side), 57 nets.
