bikerglen/poe-vfd-clock/(commit log)

2020-01-12 initial checkin
    [iv-12-tube-board-v2.brd, iv-12-tube-board-v2.sch, iv12-driver-board-v1.brd, iv12-driver-board-v1.sch]
2020-01-13 changed to correct version of board
    [iv12-driver-board-v1b.brd, iv12-driver-board-v1b.sch]
